FoundryPrinter/Kerrby/BOM/3dprinter_BOM2.ods

 | Lobo 3D Printer Part List
 | Lasercut Acrylic Parts |  |  | Cost/Per | Cost/Kit | Shipping
 | Material: 6mm(1/4”) Cast Acrylic sheet 24” x 14.5” |  | http://www.delviesplastics.com/ |  | 19.00 | 4.33 |  | buy in 24x48 sheets (3 units per sheet) – transluscent 1/4”
 | Laser Cutter Source: FULL_LAYOUT.PDF (generated with 0.010” laser kerf compensation)
Qnty | Pieces: | File Name / Part Number:
2 | Side | Support_Bracket.SPDPRT
1 | Back Plate | Back_Plate.SLDPRT
1 | Bottom Plate | Bottom_Plate.SLDPRT
1 | Print Table | Print_Table.SLDPRT
2 | Z Carriage Side | Z_Carriage_Side.SLDPRT
3 | Carriage Plate | Carriage_Plate.SLDPRT
12 | Rail Bracket | Rail_Bracket.SLDPRT
2 | Belt Clamp | Belt_Puller.SLDPRT
1 | Back Cover | Electronics_Cover.SLDPRT
1 | Foot | Stablizer_Foot.SLDPRT
 | 3D Printed Parts (PLA)
1 | Rocker Arm | rocker.SLDPRT, ROCKER.STL
1 | Duct | blowerduct.SLDPRT, blowerduct.STL
1 | Tube Clamp | Extruder_Top_Tube_Holder.SLDPRT, Extruder_Top_Tube_Holder.STL
2 | Pulley | MXL18_PRINT.SLDPRT, MXL18_PRINT.STL
1 | SD Adapter Holder | SDHOLDER.SLDPRT, SDHOLDER.STL (optional)
 | Fabricated Metal Parts
6 | Rail | 1/2” x 1/8”Aluminum Angle x 8.5” long,6063-T52, hard anodize (Type III) |  | 0.71 | 4.26 | 4.63 |  | 5' lengths https://www.onlinemetals.com/merchant.cfm?pid=1014&step=4&showunits=inches&id=63&top_cat=60
1 | Extruder Plate | EXTRUDERPLATE.SLDPRT, (0.125” aluminum plate) |  | 5.00 | 5.00
1 | Heater Block | HEATERBLOCK.SLDPRT (aluminum) |  | 8.00 | 8.00
1 | Feeder Tube | TUBE.SLDPRT, McMaster 6100K482 |  | 1.25 | 1.25 |  |  | Alternate ? 8987K24
1 | Tube Clamp | TUBECLAMP.SLDPRT (aluminum) |  | 6.00 | 6.00
1 | Spring Bracket | (1/16” aluminum sheet) |  | 2.00 | 2.00
1 | Build Plate | (1/16” aluminum sheet) |  | 1.00 | 1.00 |  | 27.51
 | Mechanical Components
4 | Motor | Wantai Nema 17, 34mm, .4A |  | 9.86 | 39.44 | 0.00 |  | http://www.ebay.com/itm/Free-shipping-10PCS-CNC-Nema17-12VDC-2800g-cm-34mm-length-4-Lead-1-8-/140906378602
1 | Blower | Digikey.com 259-1316-ND |  | 8.00 | 8.00
15 | Bearing | 608-2RS bearing |  | 0.35 | 5.25 | 0.00 |  | http://www.ebay.com/itm/Qty-100-608-2RS-two-side-rubber-seals-bearing-608-rs-ball-bearings-608-rs-/130963688742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
42 | Belting | MXL 1/4” wide |  | 0.10 | 4.20 | 0.00 |  | 2x24” lengths http://www.ebay.com/itm/261451500198
1 | Nozzle | MK8 compatible |  | 1.50 | 1.50 | 0.00 |  | http://www.ebay.com/itm/5pcs-0-4mm-Copper-Extruder-Nozzle-Print-Head-1-75mm-MK8-3D-Printer-/301583572301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
1 | Drive Gear |  |  | 3.08 | 3.08 | 0.00 |  | http://www.ebay.com/itm/221680385921
1 | Teflon Sleeve 0.022 ID | McMaster 5335K12 |  |  |  |  |  | 4 Inches per unit
1 | Teflon Sleeve 0.076” ID | McMaster 5335K18 |  | 0.08 | 0.08 |  |  | 2” per unit
1 | Nylon Spacer ¼ OD x 5/8 | McMaster 94639A107 |  | 0.09 | 0.09
1 | Spring 1.375" Long,.281" OD | McMaster 9657K108 |  | 0.53 | 0.53 |  |  | Century C-612
2 | 6-32 x 1/4” set screw | McMaster 92313A144 |  | 0.03 | 0.06
4 | 4-40 x 3/16 pan head | McMaster 90272A105 |  | 0.02 | 0.06
1 | 4-40 x 3/8 pan head | McMaster 90272A108 |  | 0.02 | 0.02
1 | 6-32 x 2” pan | McMaster 90272A159 |  | 0.06 | 0.06
3 | 8-32 x 5/8 FH Socket | McMaster 92210A196 |  | 0.06 | 0.18
12 | 8-32 x ½ FH Socket | McMaster 92210A194 |  | 0.06 | 0.72
1 | M3 x 25mm | McMaster 92005A130 |  | 0.03 | 0.03
9 | M3 x 10mm | McMaster 92005A120 |  | 0.03 | 0.27
3 | 6-32 x ½ Pan Head | McMaster 90272A148 |  | 0.02 | 0.06
34 | 6-32 x 3/8 Pan Head | McMaster 90272A146 |  | 0.02 | 0.68
6 | 6-32 square nut | McMaster 94855A201 |  | 0.02 | 0.12
30 | #8 Plastic Washers | McMaster 90295A410 |  | 0.07 | 2.10
4 | Rubber feet | Hardware Sales |  | 0.15 | 0.60 |  | 67.125
4 | 4-40 M/F standoff x 6mm ( .25 in ) | McMaster 93505A855 |  | 0.36 | 1.44 |  |  | Jameco 393458
2 | 3/16 feeder tube | McMaster 5112K43 |  | 0.44 | 0.88 |  |  | 5548K65
 | m3 x 6mm Pan Head | McMaster 92005A116
 | Electronic Components
1 | Printrboard |  |  | 50.00 | 50.00 | 0.00 |  | http://www.ebay.com/itm/New-Version-Printerboard-Controller-Board-for-Reprap-Prusa-Mendel-3D-Printer-/271504944560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
1 | Heater Cartridge |  |  | 1.67 | 1.67 | 0.00 |  | http://www.ebay.com/itm/201158692987
1 | Thermistor | Digikey 615-1028-ND |  | 1.10 | 1.10
5 | 4-Pin Locking Housing | Digikey WM2002-ND |  | 0.25 | 1.25
1 | 2-Pin Locking Housing | Digikey WM2000-ND |  | 0.20 | 0.20
22 | Sockets for locking conn. | Digikey WM1114-ND |  | 0.07 | 1.54
1 | Connector strip | Jameco.com 103158 |  | 0.60 | 0.60 |  |  | 36 position strip
15 | Sockets for housing | Jameco.com 100766 |  | 0.07 | 1.05
15 | Pins for housing | Jameco.com 145358 |  | 0.07 | 1.05
1 | Power Supply | Newegg.com 9SIA70F2KM9750 |  | 9.35 | 9.35
1 | USB Cable | Newegg.com 9SIA7X42VY8433 |  | 2.00 | 2.00
1 | Power Switch | Digikey CW198-ND |  | 2.00 | 2.00
1 | Power Jack | Digikey CP-6-ND |  | 1.50 | 1.50
1 | Molex power conn. | Digikey WM3701-ND |  | 0.50 | 0.50
2 | Molex pins | Digikey WM2501-ND |  | 0.12 | 0.24
1 | Limit Switch | Digikey SW777-ND |  | 1.10 | 1.10
0 | SD Card Adapter (optional) |  |  | 5.60 | 0.00 |  |  | http://www.dx.com/p/sd-to-microsd-transflash-card-converter-module-27001#.VXXifM9VhBc
 | Supplies
2 | Cable | 24ga, 5 pair |  | 0.41 | 0.82 |  |  | http://www.iec-usa.com/cgi-bin/iec/CAB010-MP-L5-GY
 | Teflon Tape
48 inches | Hookup wire, 26ga | Jameco 173148, 105912
 | Superglue
 | Fishing Line | Vector Fiber 30lb |  |  | Parts | Shipping
 |  |  |  |  | 191.93 | 8.96
 |  |  |  | TOTAL COST | 200.89
