FoundryPrinter/Kerrby/Solidworks/printer.SLDASM

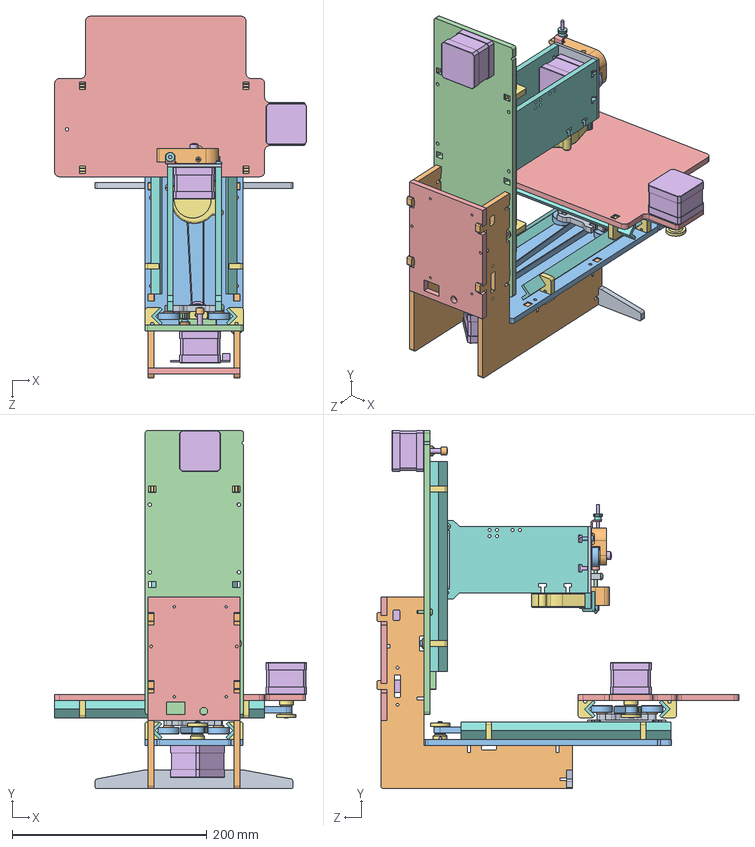
[picture p1: CAD file, 2015-07-31]
Solidworks/printer.SLDASM
259.5 x 368.0 x 371.7 mm
foot
L_bracket x 2
base2
back2
cover
printrboard
railbracket2 x 12
rail x 6
carriageplate3 x 3
washer x 19
bearing x 15
puller x 3
table2
motor x 4
MXL18_print x 2
side2 x 2
tubeclamp
heaterblock
nozzle
tube
tubetop
filamentgear
blower
blowerduct3
extruderplate
rocker
screw_6-32_038 x 3
screw_6-32_050 x 4
springbracket
screw_6-32_250
spring
fingernut
spacer_062
stringclamp
belt x 2
switchplate
