FoundryPrinter/Kerrby/Solidworks/hotend.SLDASM

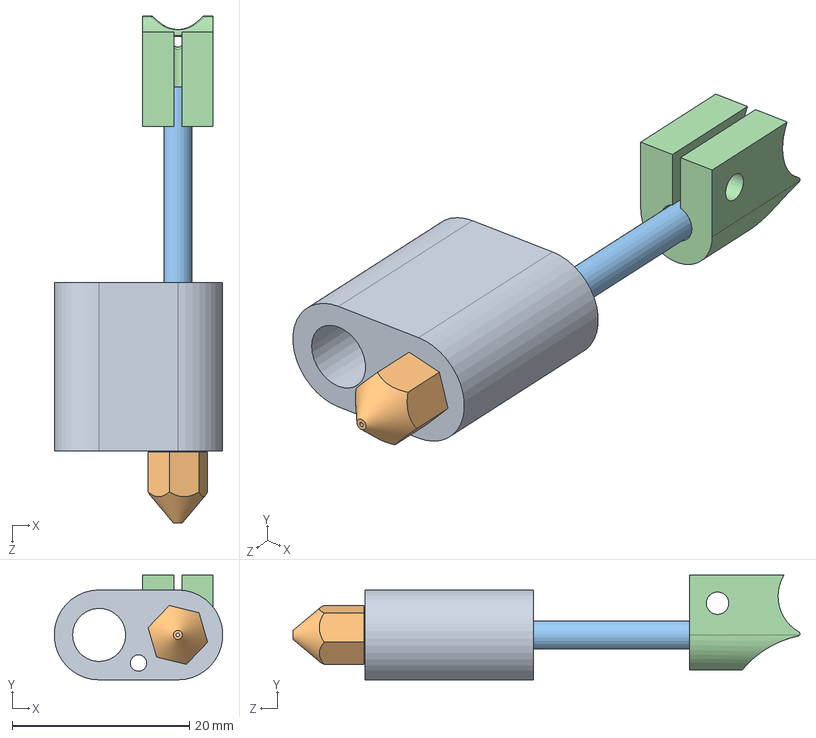
[picture p2: CAD file, 2015-07-31]
Solidworks/hotend.SLDASM
19.0 x 11.8 x 57.3 mm
heaterblock
nozzle
tube
tubetop
