FoundryPrinter/Kerrby/Solidworks/table.SLDASM

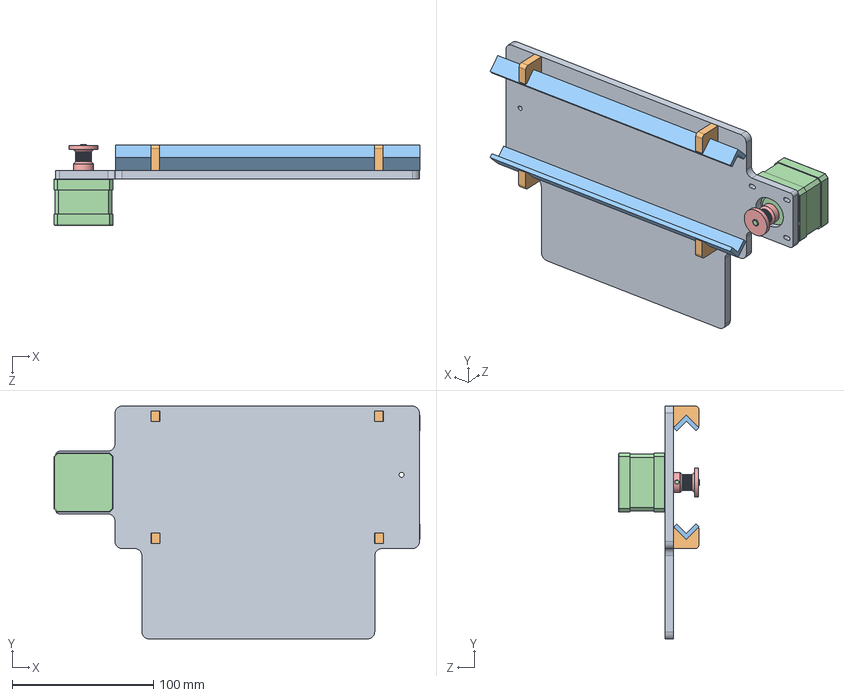
[picture p3: CAD file, 2015-07-31]
Solidworks/table.SLDASM
259.5 x 165.1 x 57.2 mm
table2
railbracket2 x 4
rail x 2
motor
MXL18_print
