FoundryPrinter/Kerrby/Solidworks/carriage.SLDASM

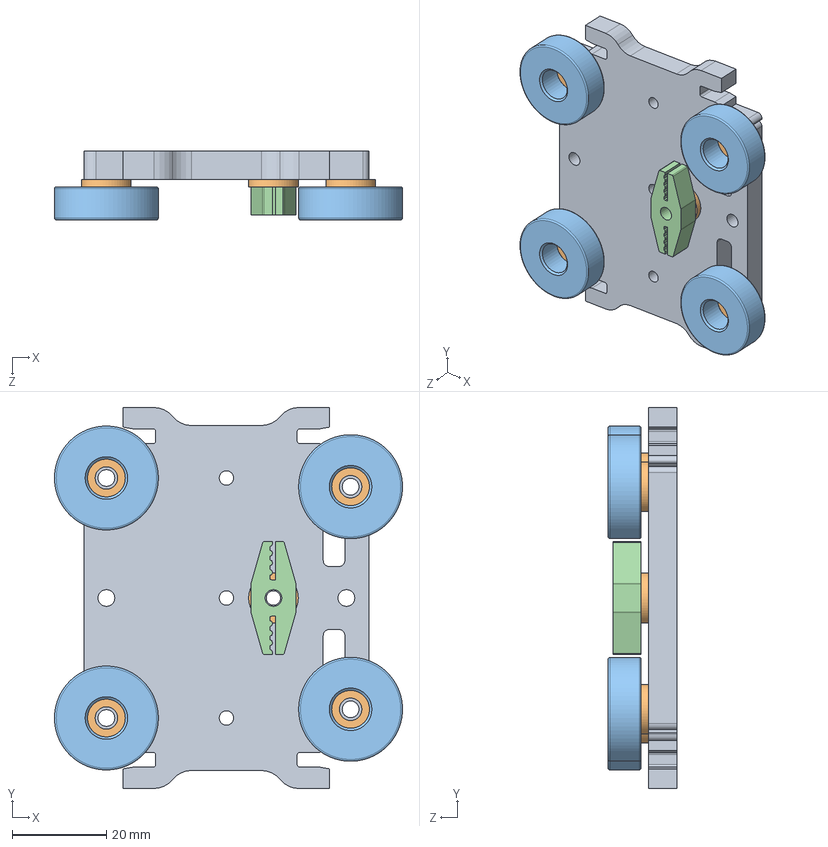
[picture p4: CAD file, 2015-07-24]
Solidworks/carriage.SLDASM
73.7 x 80.6 x 14.6 mm
carriageplate3
washer x 5
bearing x 4
puller
