FoundryPrinter/Kerrby/Solidworks/Backup For SLD 2011/spring.SLDASM

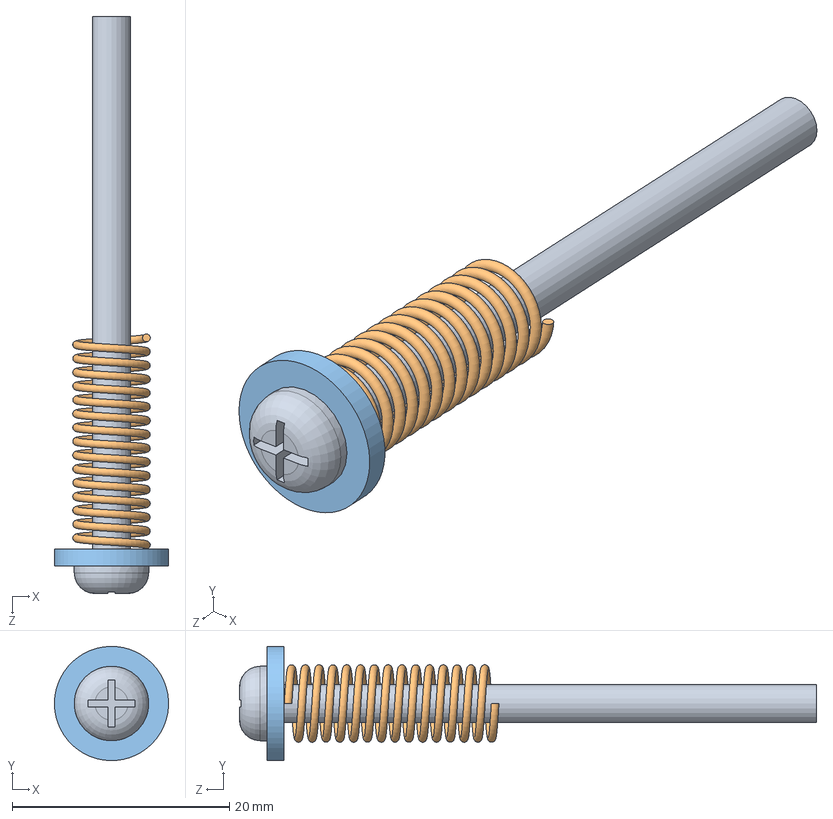
[picture p5: CAD file, 2015-07-17]
Solidworks/Backup For SLD 2011/spring.SLDASM
10.5 x 10.5 x 53.1 mm
screw_6-32_250
spring
washer
