FoundryPrinter/Kerrby/Printed Parts/Blowerduct/blowerduct3_nosupport.STL

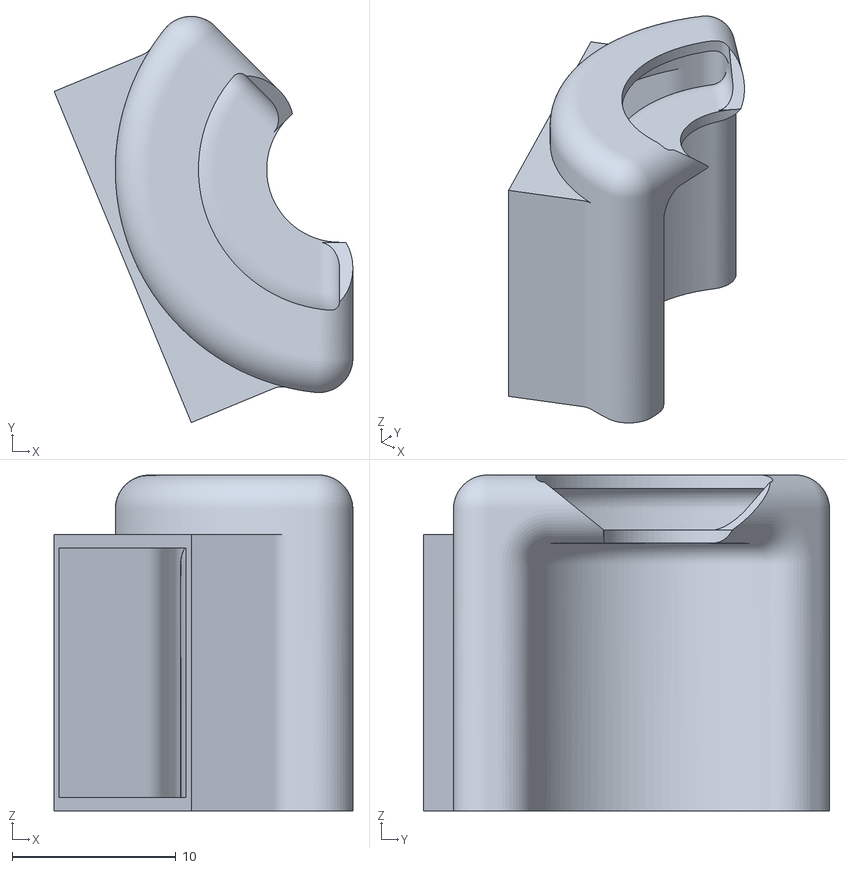
[picture p6: CAD file, 2015-07-17]
Printed Parts/Blowerduct/blowerduct3_nosupport.STL
18.2 x 24.8 x 20.5
