FoundryPrinter/Kerrby/Printed Parts/Drive_Pully/Drive_Pully_MXL18.STL

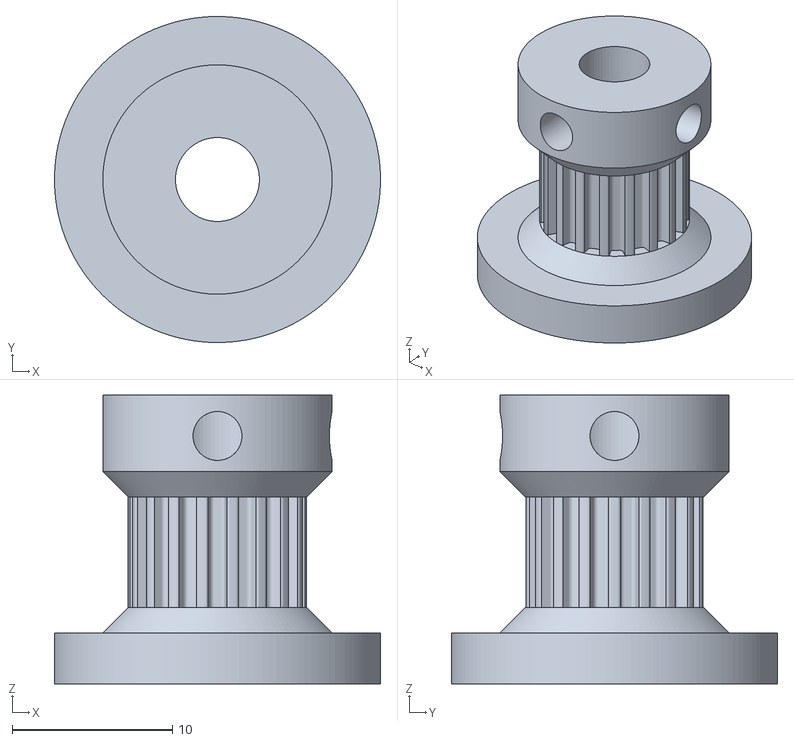
[picture p7: CAD file, 2015-07-17]
Printed Parts/Drive_Pully/Drive_Pully_MXL18.STL
20.3 x 20.3 x 18.0
