FoundryPrinter/Kerrby/Printed Parts/Extruder_Top_Tube_Holder/Extruder_Top_Tube_Holder.STL

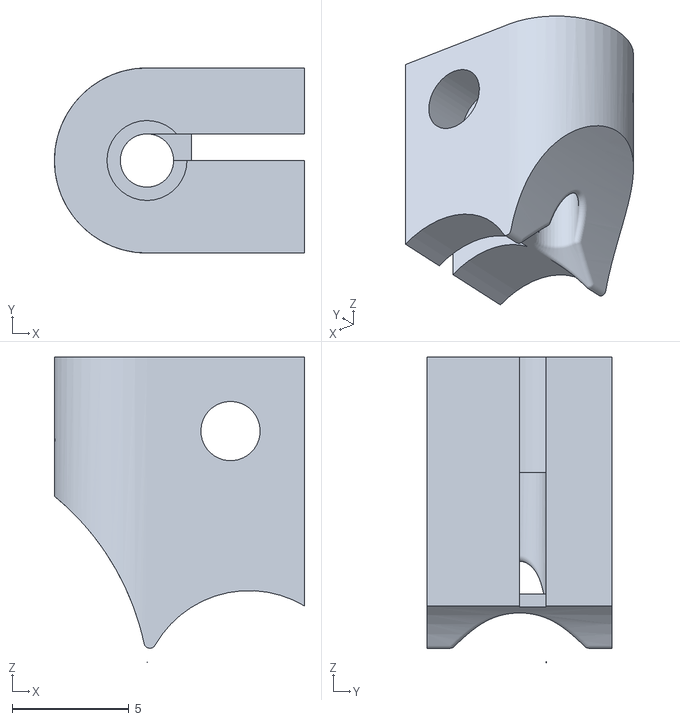
[picture p8: CAD file, 2015-07-31]
Printed Parts/Extruder_Top_Tube_Holder/Extruder_Top_Tube_Holder.STL
10.7 x 7.94 x 13.1
