FoundryPrinter/Kerrby/Printed Parts/Filiment_Rocker/Filiment_Rocker.STL

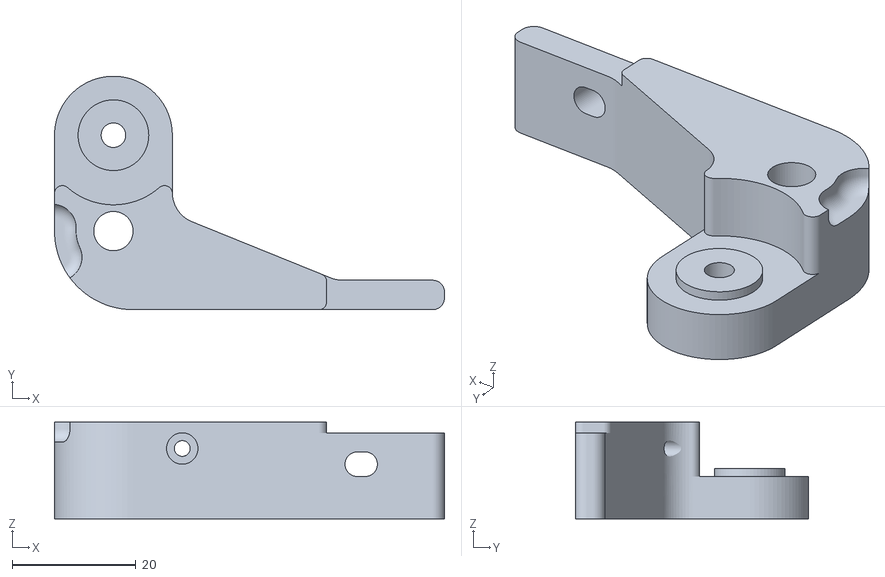
[picture p9: CAD file, 2015-07-17]
Printed Parts/Filiment_Rocker/Filiment_Rocker.STL
63.0 x 37.7 x 15.6
