FoundryPrinter/Kerrby/Printed Parts/SD_Card_Holder/SD_Card_Holder.STL

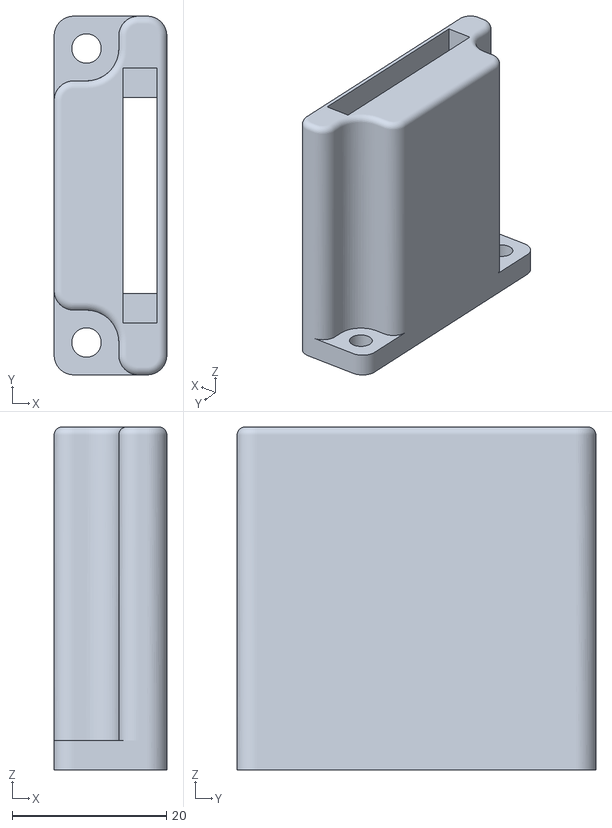
[picture p10: CAD file, 2015-07-17]
Printed Parts/SD_Card_Holder/SD_Card_Holder.STL
14.6 x 46.5 x 44.5
