FoundryPrinter/Kerrby/Solidworks/Backup For SLD 2011/bearing.SLDPRT

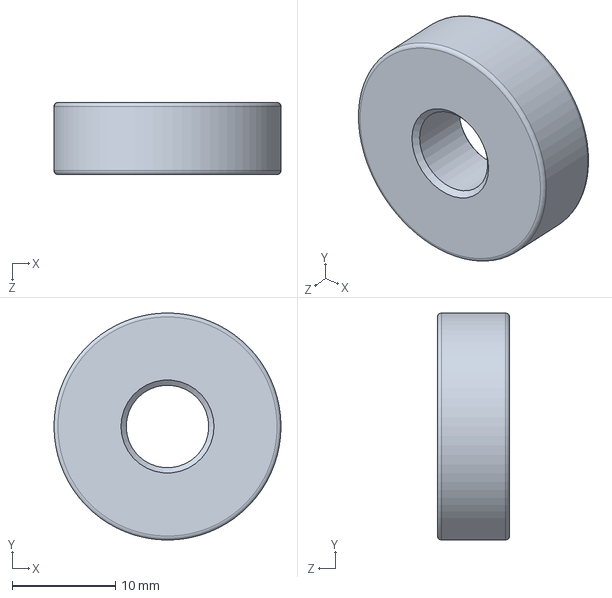
[picture p11: CAD file, 2015-07-17]
Solidworks/Backup For SLD 2011/bearing.SLDPRT
22.0 x 22.0 x 7.00 mm
