FoundryPrinter/Kerrby/Solidworks/Backup For SLD 2011/sdholder_flanged.SLDPRT

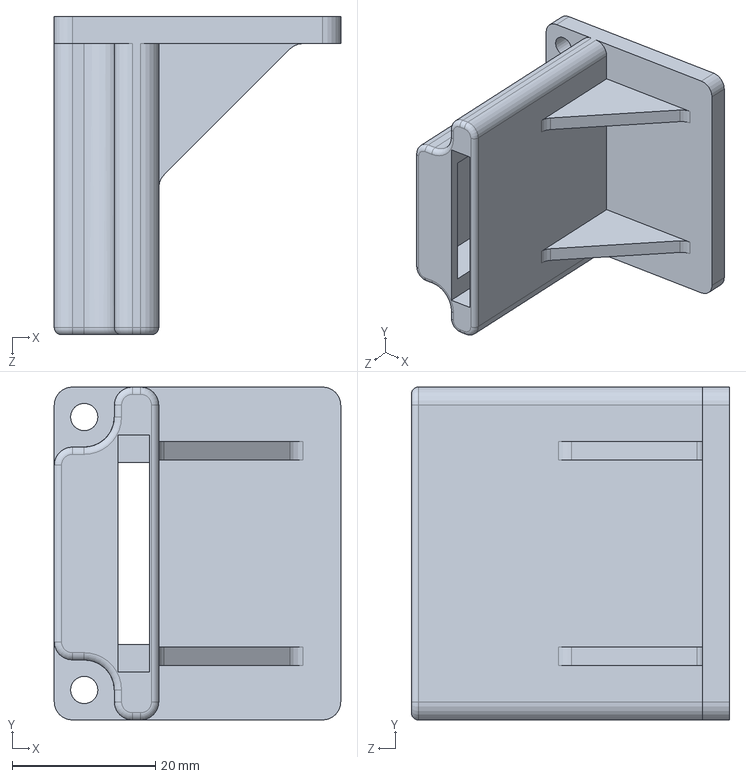
[picture p12: CAD file, 2015-07-17]
Solidworks/Backup For SLD 2011/sdholder_flanged.SLDPRT
40.0 x 46.5 x 44.5 mm
