FoundryPrinter/Kerrby/Solidworks/Backup For SLD 2011/puller.SLDPRT

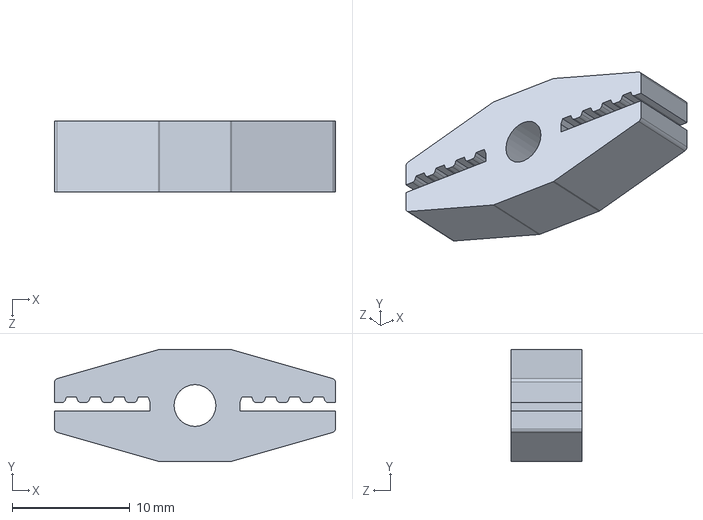
[picture p13: CAD file, 2015-07-17]
Solidworks/Backup For SLD 2011/puller.SLDPRT
23.9 x 9.53 x 6.00 mm
