FoundryPrinter/Kerrby/Solidworks/Backup For SLD 2011/blower.SLDPRT

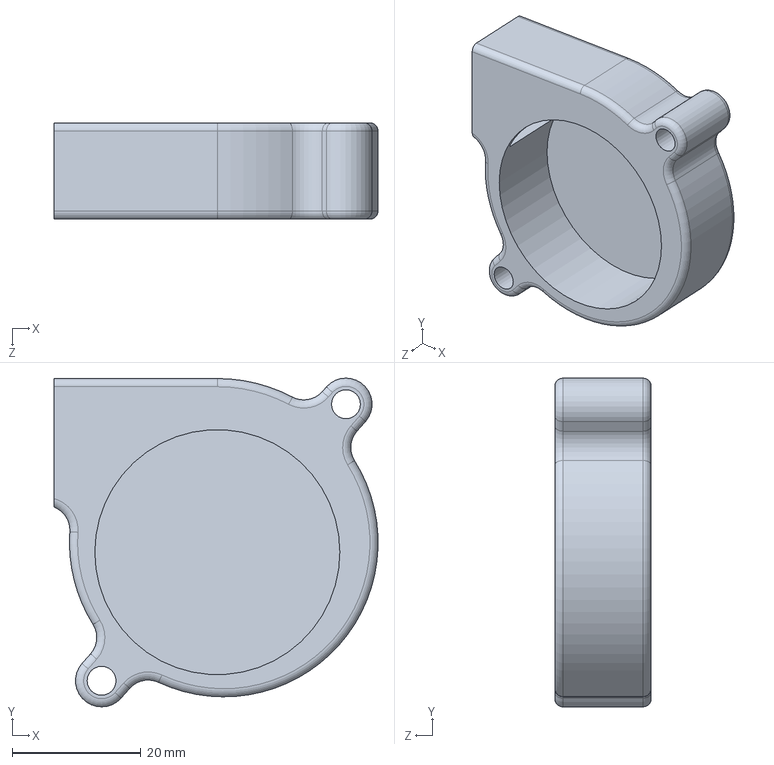
[picture p14: CAD file, 2015-07-17]
Solidworks/Backup For SLD 2011/blower.SLDPRT
50.4 x 51.1 x 15.0 mm
