FoundryPrinter/Kerrby/Solidworks/Backup For SLD 2011/extruderplate.SLDPRT

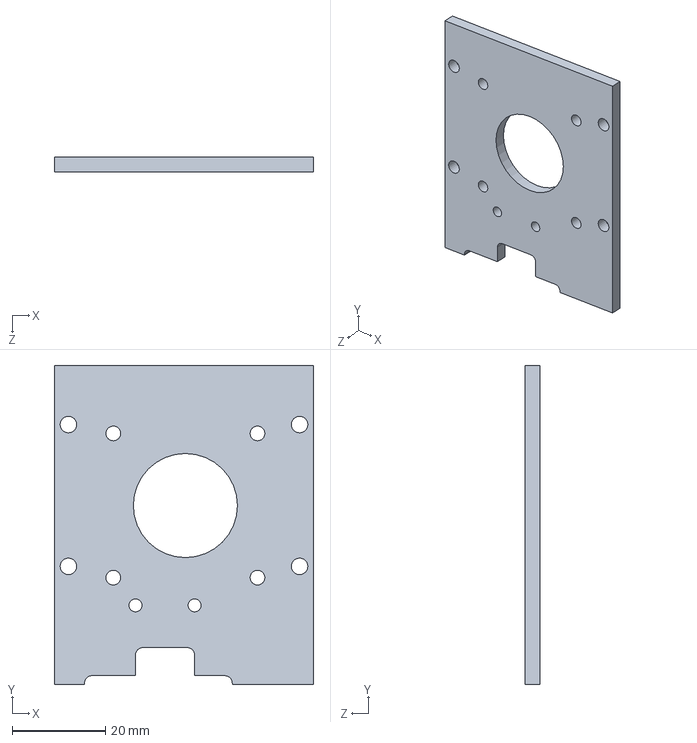
[picture p15: CAD file, 2015-07-17]
Solidworks/Backup For SLD 2011/extruderplate.SLDPRT
55.7 x 68.6 x 3.17 mm
