FoundryPrinter/Kerrby/Solidworks/Bottom_Plate.SLDPRT

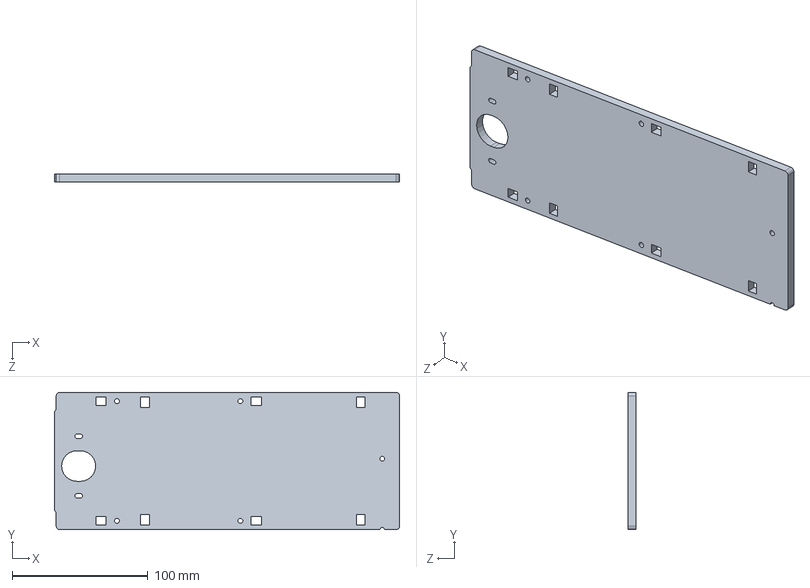
[picture p16: CAD file, 2015-07-17]
Solidworks/Bottom_Plate.SLDPRT
254.0 x 101.0 x 6.00 mm
