FoundryPrinter/Kerrby/Solidworks/Support_Bracket.SLDPRT

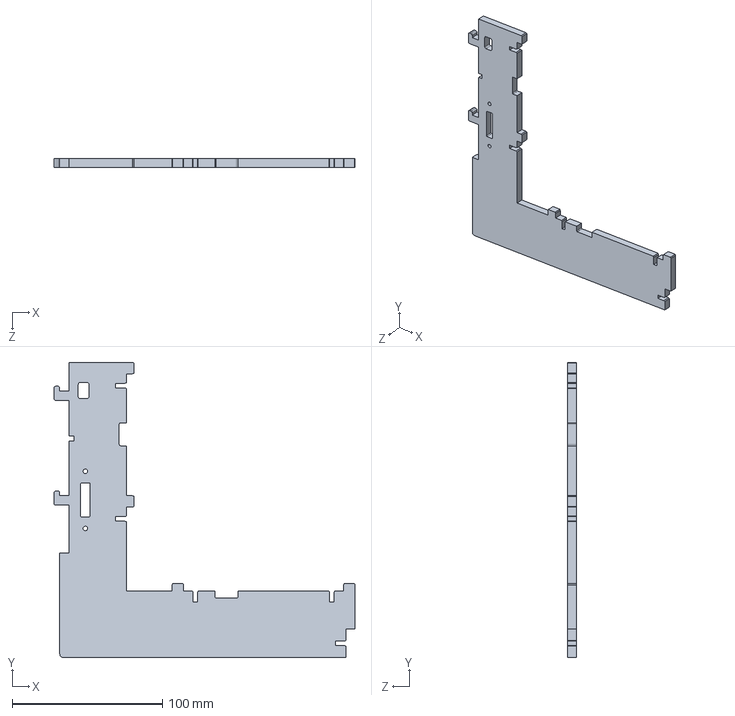
[picture p17: CAD file, 2015-07-17]
Solidworks/Support_Bracket.SLDPRT
200.7 x 196.9 x 6.00 mm
