FoundryPrinter/Kerrby/Solidworks/Backup For SLD 2011/switchplate.SLDPRT

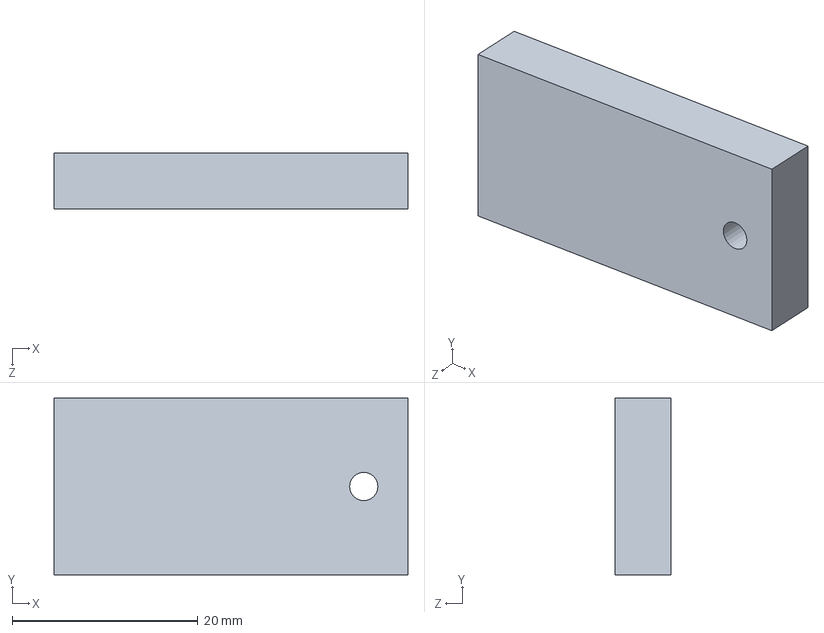
[picture p18: CAD file, 2015-07-17]
Solidworks/Backup For SLD 2011/switchplate.SLDPRT
38.1 x 19.1 x 6.00 mm
