FoundryPrinter/Kerrby/Solidworks/Support_Foot.SLDPRT

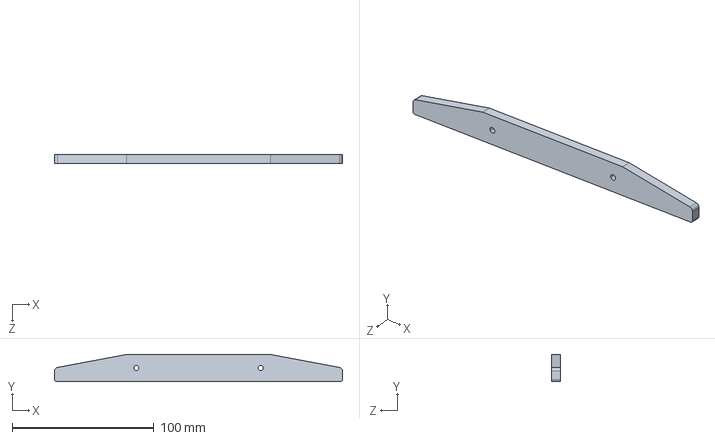
[picture p19: CAD file, 2015-07-17]
Solidworks/Support_Foot.SLDPRT
203.2 x 19.1 x 6.00 mm
