FoundryPrinter/Kerrby/Solidworks/Electronics_Cover.SLDPRT

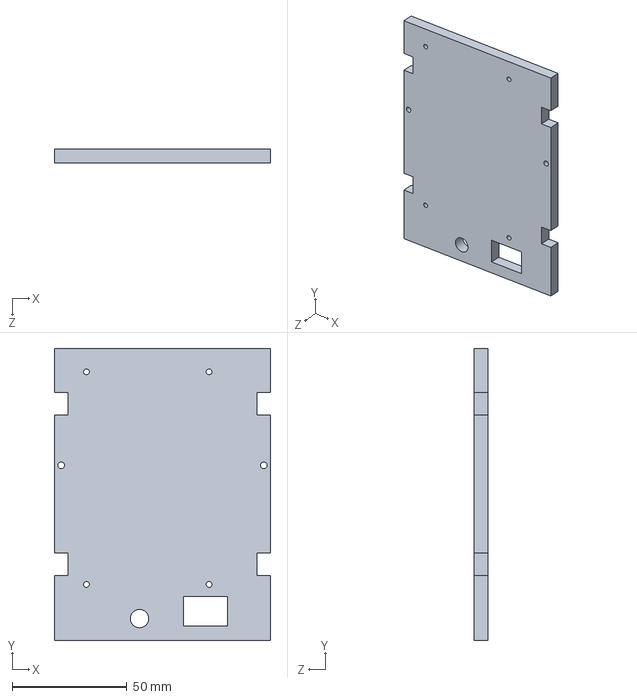
[picture p20: CAD file, 2015-07-17]
Solidworks/Electronics_Cover.SLDPRT
94.1 x 127.0 x 6.00 mm
