FoundryPrinter/Kerrby/Solidworks/Back_Plate.SLDPRT

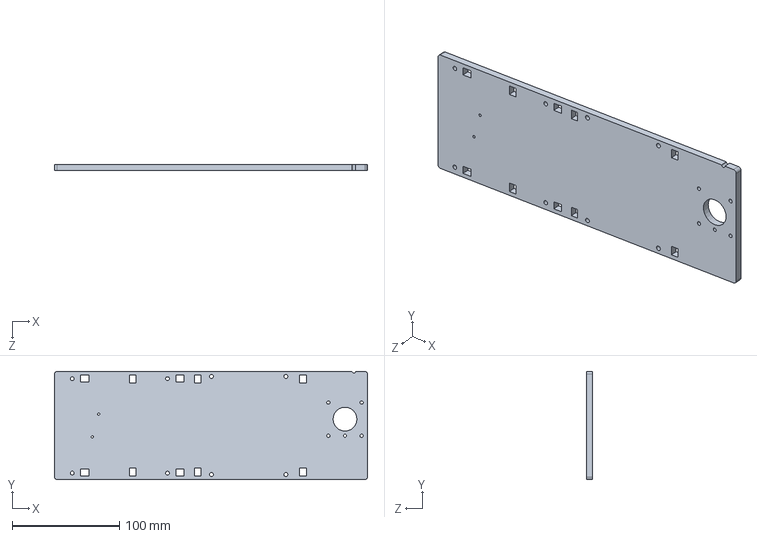
[picture p21: CAD file, 2015-07-17]
Solidworks/Back_Plate.SLDPRT
292.1 x 101.0 x 6.00 mm
