FoundryPrinter/Kerrby/Solidworks/Backup For SLD 2011/spacer_062.SLDPRT

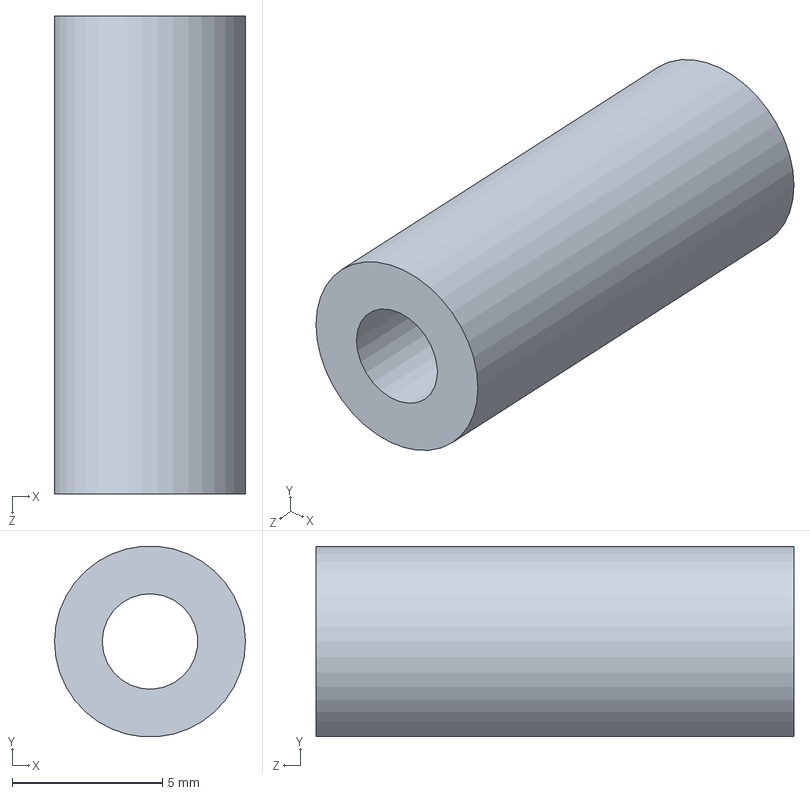
[picture p22: CAD file, 2015-07-17]
Solidworks/Backup For SLD 2011/spacer_062.SLDPRT
6.35 x 6.33 x 15.9 mm
