FoundryPrinter/Kerrby/Solidworks/Rail_Bracket.SLDPRT

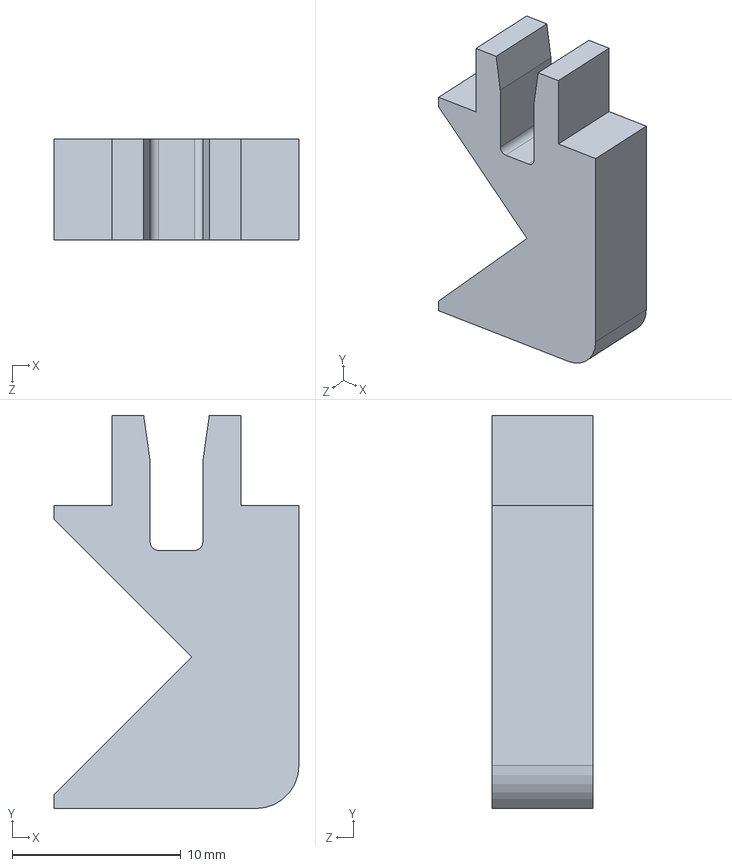
[picture p23: CAD file, 2015-07-17]
Solidworks/Rail_Bracket.SLDPRT
14.5 x 23.3 x 6.00 mm
