FoundryPrinter/Kerrby/Solidworks/Print_Table.SLDPRT

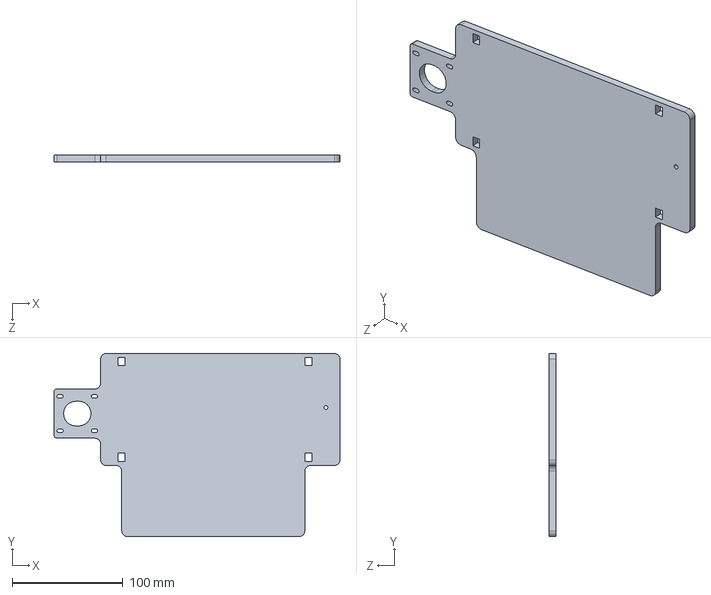
[picture p24: CAD file, 2015-07-17]
Solidworks/Print_Table.SLDPRT
257.9 x 165.1 x 6.00 mm
