FoundryPrinter/Kerrby/Solidworks/Carriage_Plate.SLDPRT

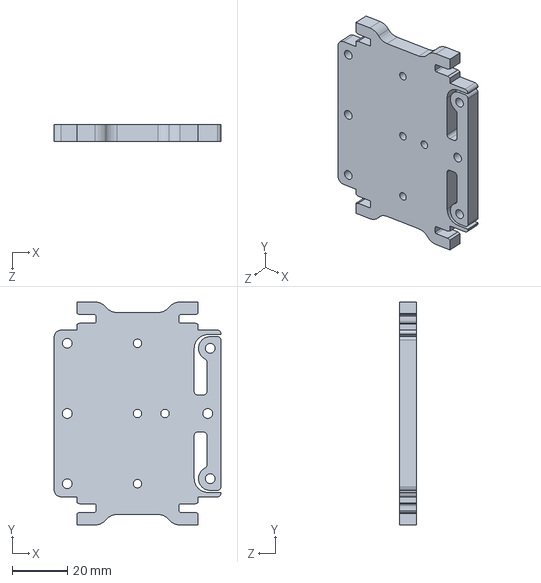
[picture p25: CAD file, 2015-07-17]
Solidworks/Carriage_Plate.SLDPRT
60.3 x 80.6 x 6.00 mm
