FoundryPrinter/Kerrby/Solidworks/Backup For SLD 2011/belt.SLDPRT

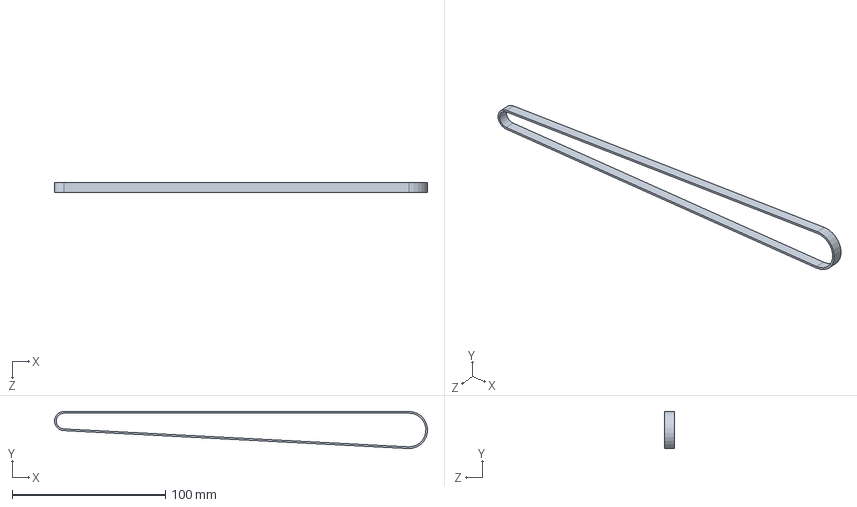
[picture p26: CAD file, 2015-07-17]
Solidworks/Backup For SLD 2011/belt.SLDPRT
243.5 x 24.2 x 6.35 mm
