FoundryPrinter/Kerrby/Solidworks/Z_Carriage_Side.SLDPRT

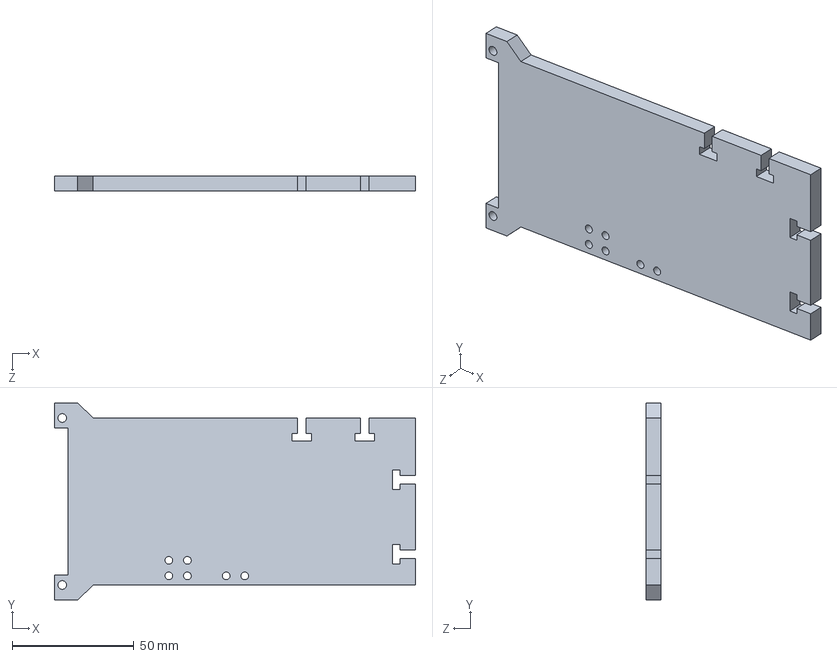
[picture p27: CAD file, 2015-07-17]
Solidworks/Z_Carriage_Side.SLDPRT
148.0 x 80.6 x 6.00 mm
