FoundryPrinter/Kerrby/Solidworks/Backup For SLD 2011/printrboard.SLDPRT

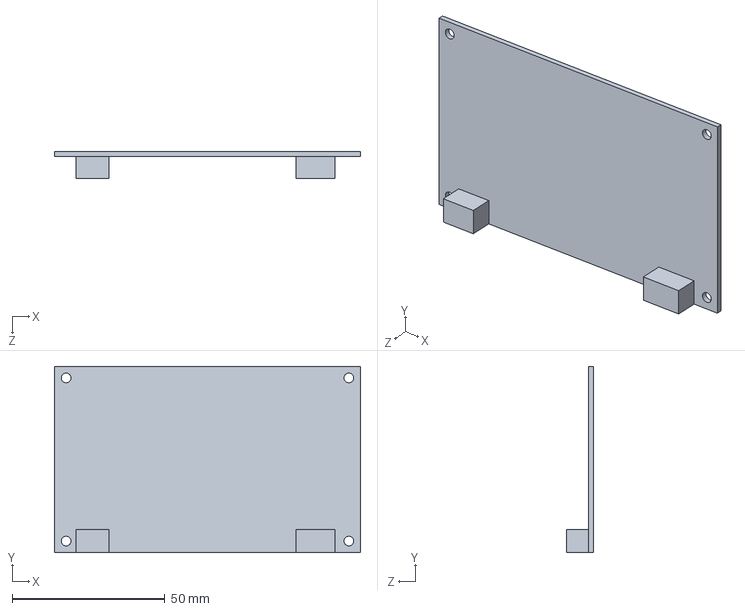
[picture p28: CAD file, 2015-07-17]
Solidworks/Backup For SLD 2011/printrboard.SLDPRT
100.1 x 61.0 x 8.69 mm
