FoundryPrinter/Kerrby/Solidworks/Backup For SLD 2011/fingernut.SLDPRT

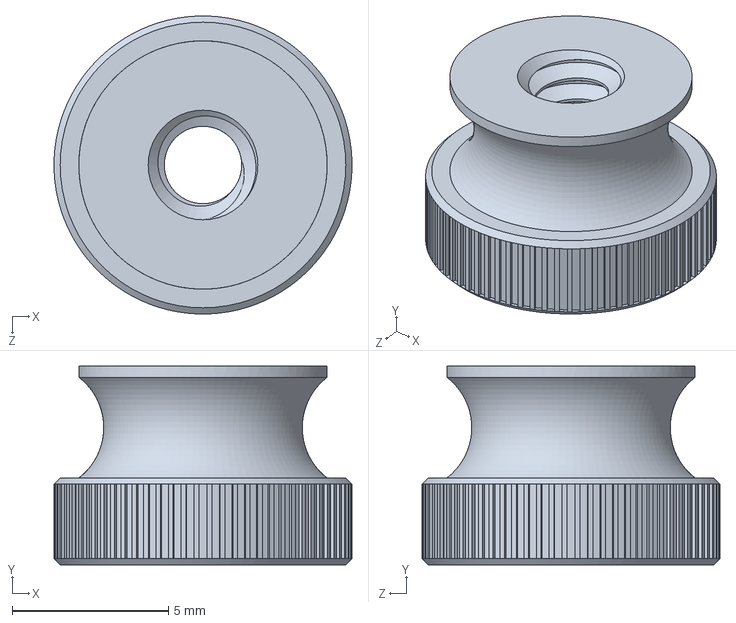
[picture p29: CAD file, 2015-07-17]
Solidworks/Backup For SLD 2011/fingernut.SLDPRT
9.53 x 6.35 x 9.53 mm
