FoundryPrinter/Kerrby/Solidworks/Backup For SLD 2011/tensionbracket.SLDPRT

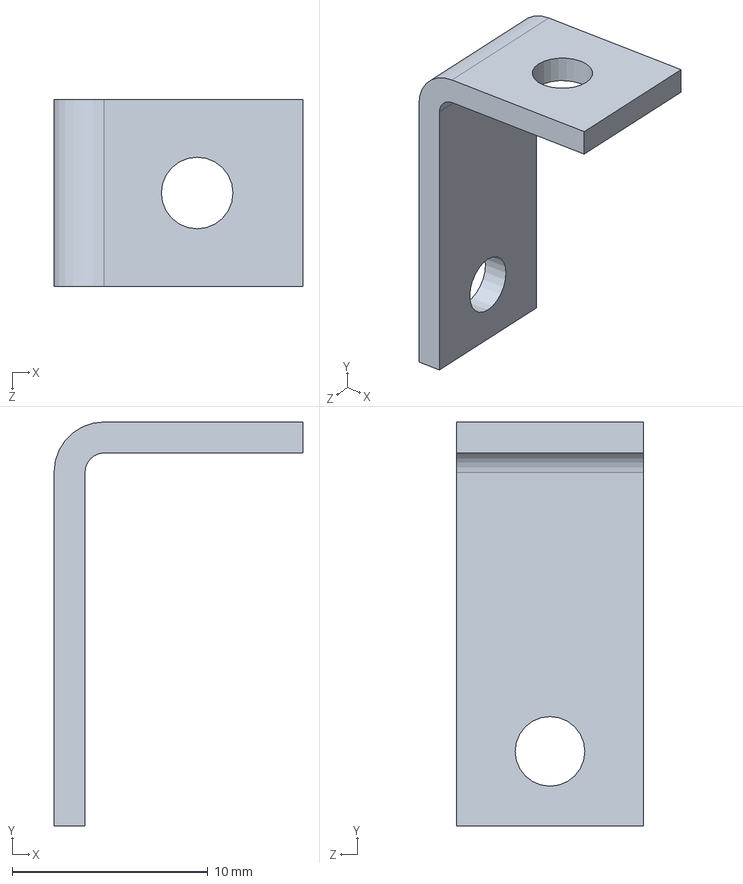
[picture p30: CAD file, 2015-07-17]
Solidworks/Backup For SLD 2011/tensionbracket.SLDPRT
12.7 x 20.6 x 9.53 mm
