FoundryPrinter/Kerrby/Solidworks/Backup For SLD 2011/heaterblock.SLDPRT

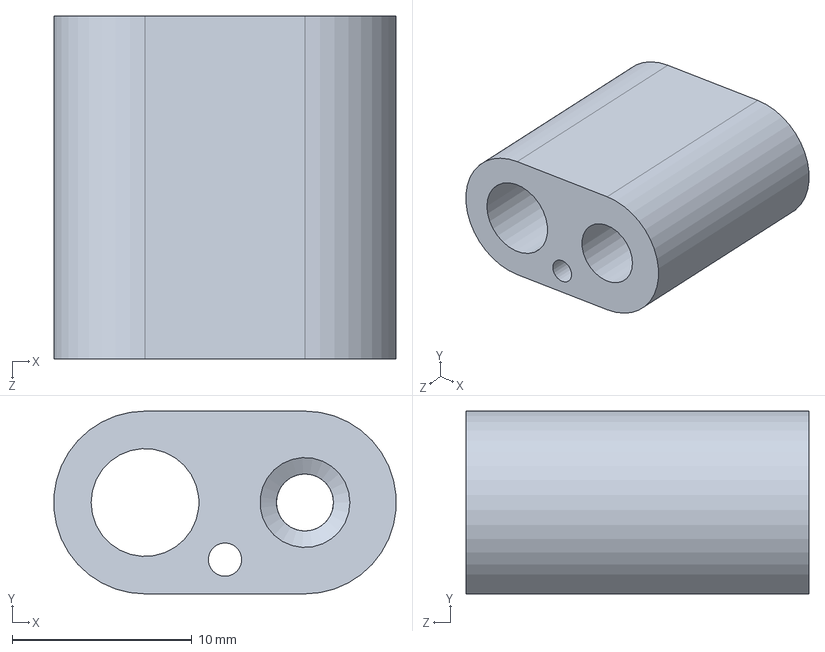
[picture p31: CAD file, 2015-07-17]
Solidworks/Backup For SLD 2011/heaterblock.SLDPRT
19.0 x 10.2 x 19.1 mm
