FoundryPrinter/Kerrby/Solidworks/Backup For SLD 2011/motor.SLDPRT

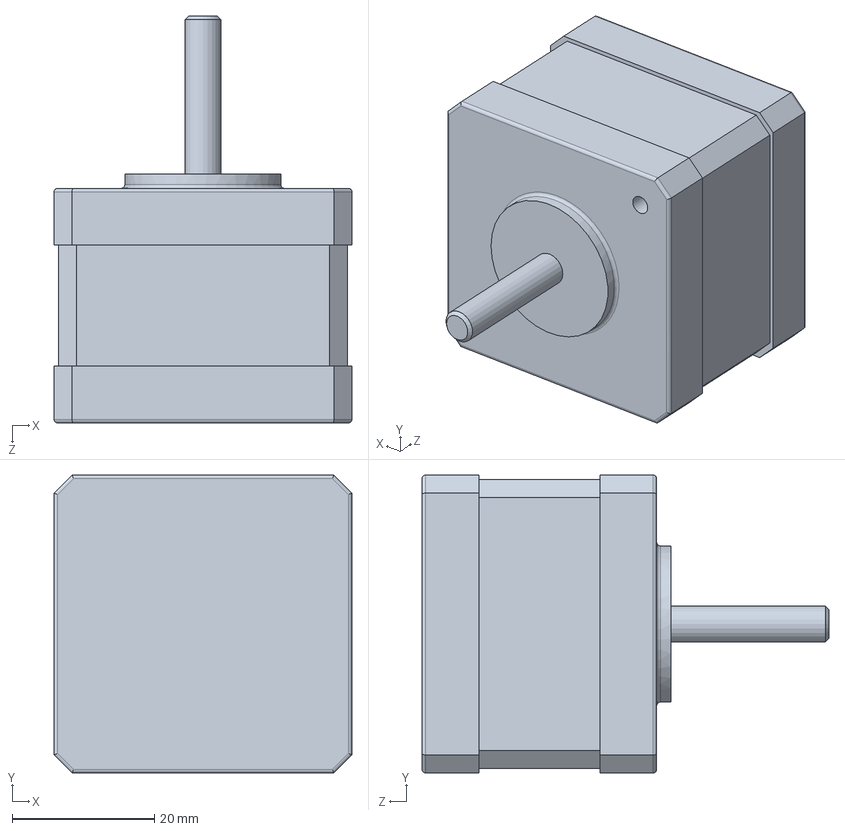
[picture p32: CAD file, 2015-07-17]
Solidworks/Backup For SLD 2011/motor.SLDPRT
41.9 x 41.9 x 57.2 mm
