FoundryPrinter/Kerrby/Solidworks/Backup For SLD 2011/springbracket.SLDPRT

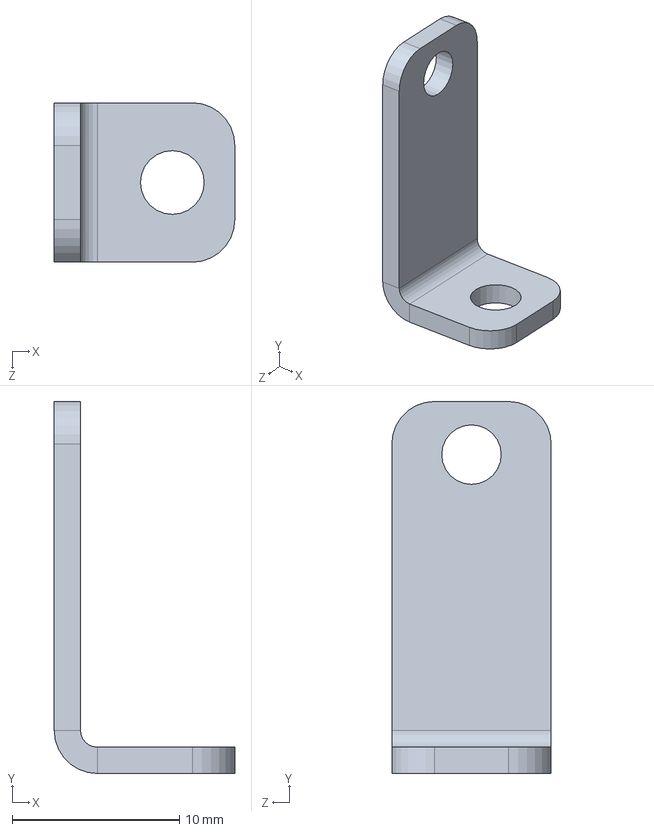
[picture p33: CAD file, 2015-07-17]
Solidworks/Backup For SLD 2011/springbracket.SLDPRT
10.8 x 22.2 x 9.53 mm
