FoundryPrinter/Kerrby/Solidworks/Backup For SLD 2011/stringclamp.SLDPRT

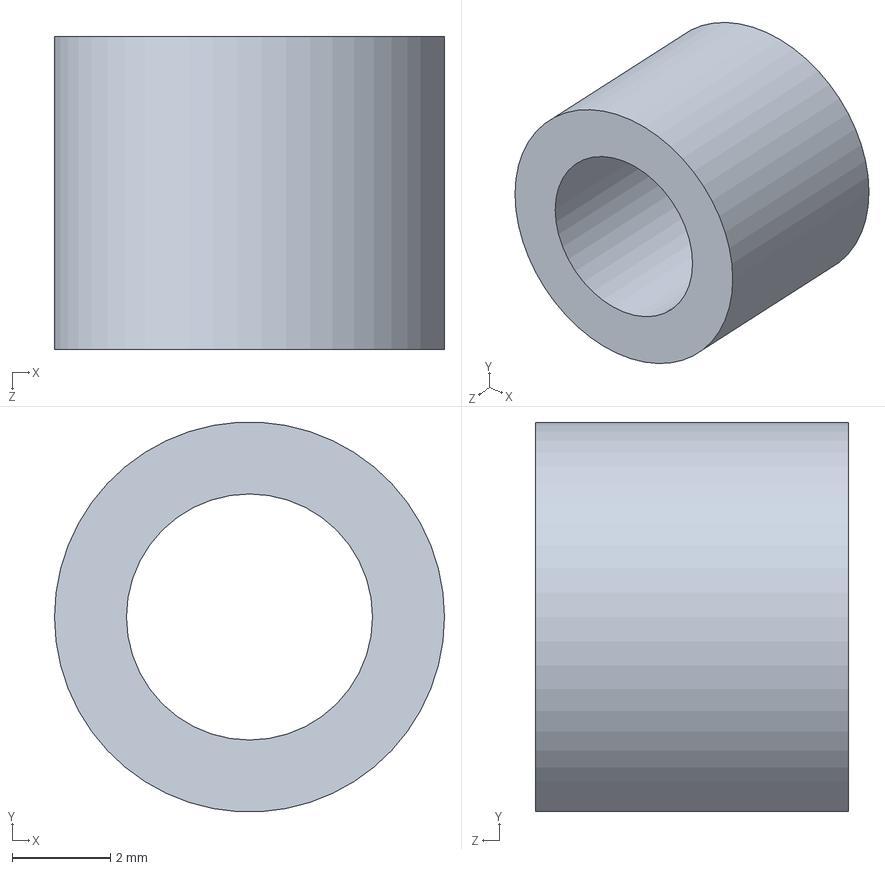
[picture p34: CAD file, 2015-07-17]
Solidworks/Backup For SLD 2011/stringclamp.SLDPRT
7.92 x 7.91 x 6.35 mm
