FoundryPrinter/Kerrby/Solidworks/Backup For SLD 2011/tube.SLDPRT

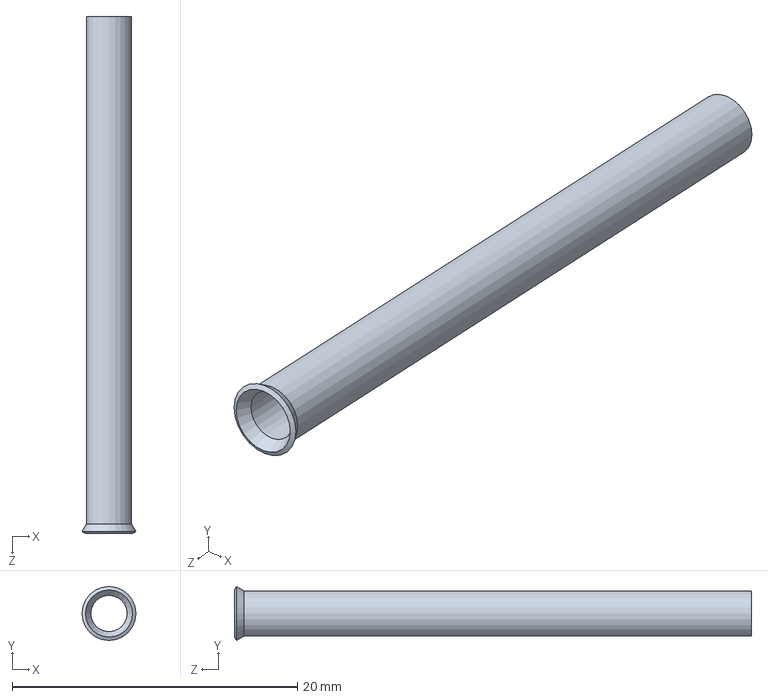
[picture p35: CAD file, 2015-07-17]
Solidworks/Backup For SLD 2011/tube.SLDPRT
3.78 x 3.78 x 36.2 mm
