FoundryPrinter/Kerrby/Solidworks/Backup For SLD 2011/tubeclamp.SLDPRT

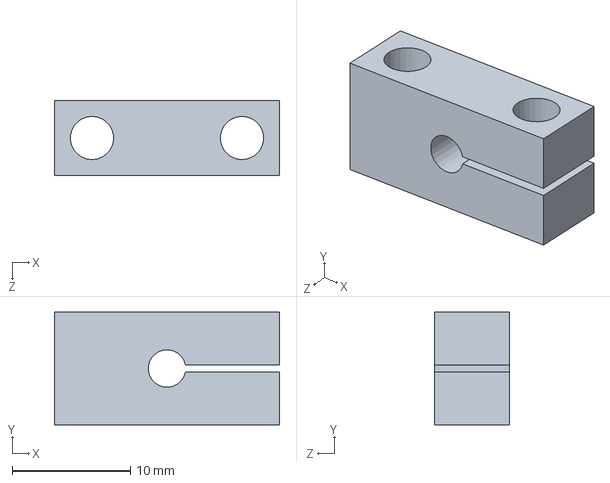
[picture p36: CAD file, 2015-07-17]
Solidworks/Backup For SLD 2011/tubeclamp.SLDPRT
19.1 x 9.53 x 6.35 mm
