FoundryPrinter/Kerrby/Solidworks/Backup For SLD 2011/filamentgear.SLDPRT

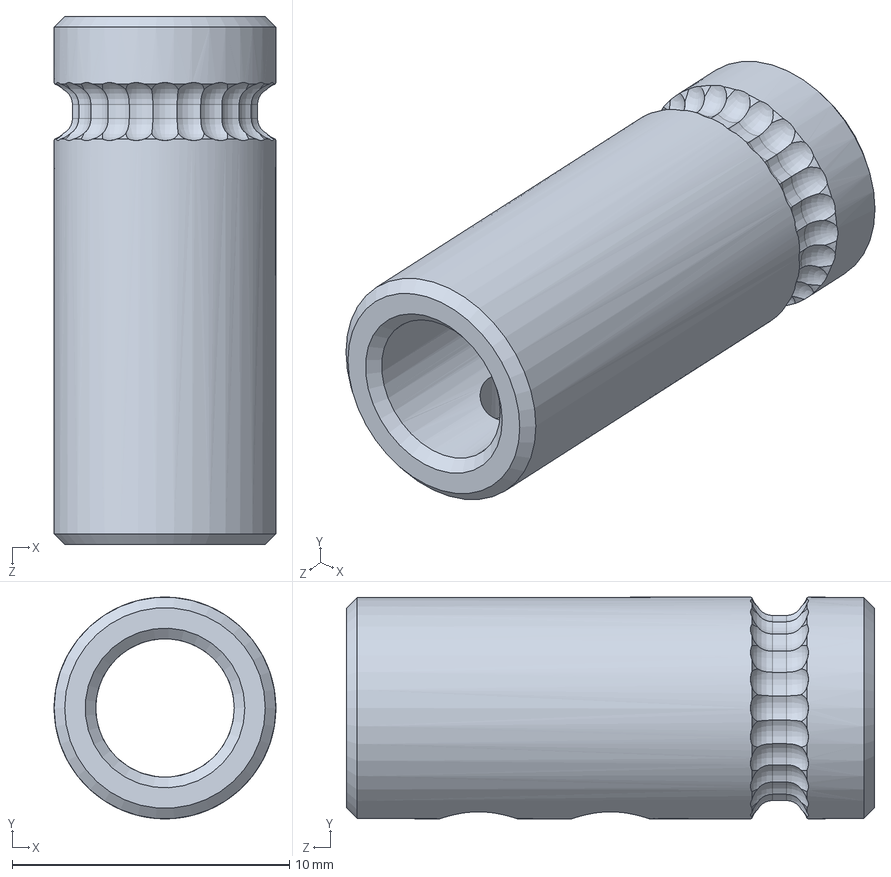
[picture p37: CAD file, 2015-07-17]
Solidworks/Backup For SLD 2011/filamentgear.SLDPRT
8.00 x 8.00 x 19.1 mm
