FoundryPrinter/Kerrby/Solidworks/Backup For SLD 2011/nozzle.SLDPRT

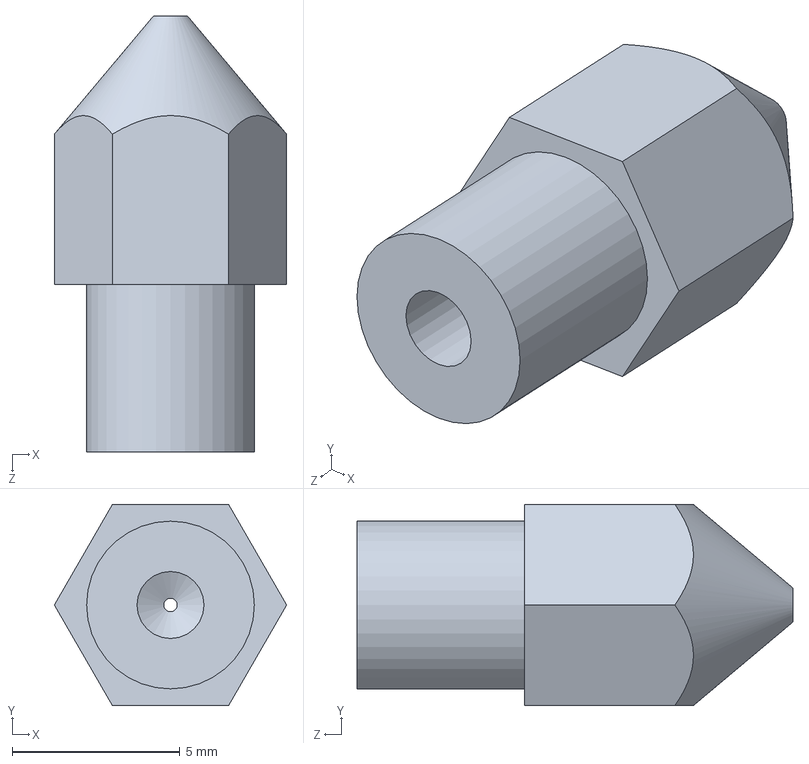
[picture p38: CAD file, 2015-07-17]
Solidworks/Backup For SLD 2011/nozzle.SLDPRT
6.93 x 6.00 x 13.0 mm
