FoundryPrinter/Kerrby/Solidworks/Backup For SLD 2011/rail.SLDPRT

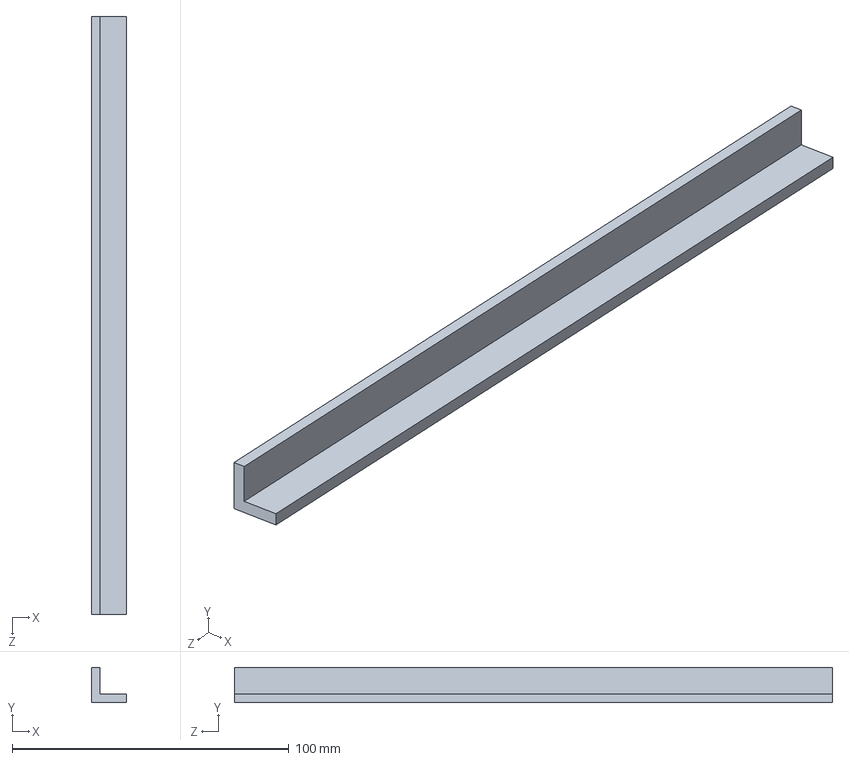
[picture p39: CAD file, 2015-07-17]
Solidworks/Backup For SLD 2011/rail.SLDPRT
12.7 x 12.7 x 215.9 mm
