FoundryPrinter/Kerrby/Solidworks/Backup For SLD 2011/tubetop.SLDPRT

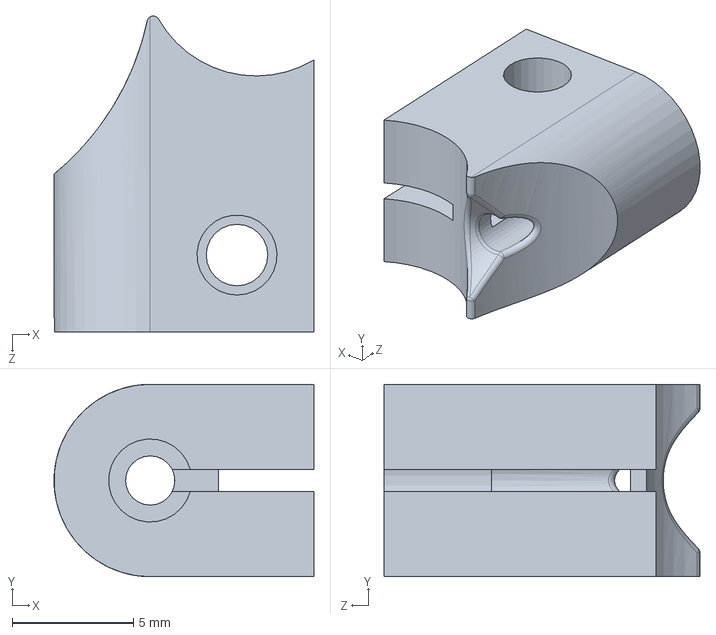
[picture p40: CAD file, 2015-07-17]
Solidworks/Backup For SLD 2011/tubetop.SLDPRT
10.7 x 7.94 x 13.0 mm
