FoundryPrinter/Kerrby/(list of files, cad)

Other CAD files:
Solidworks/Backup For SLD 2011/printer.SLDASM
Solidworks/Backup For SLD 2011/carriage.SLDASM
Solidworks/Backup For SLD 2011/table.SLDASM
Solidworks/Backup For SLD 2011/hotend.SLDASM
Printed Parts/Blowerduct/blowerduct3.STL
Solidworks/Extruder_Top_Tube_Holder.SLDPRT
Solidworks/Blowerduct.SLDPRT
Solidworks/Backup For SLD 2011/rocker.SLDPRT
Solidworks/Backup For SLD 2011/sdholder.SLDPRT
Solidworks/Backup For SLD 2011/MXL18_print.SLDPRT
Solidworks/Backup For SLD 2011/Drawings/L_bracket.SLDDRW
Solidworks/Backup For SLD 2011/Drawings/back2.SLDDRW
Solidworks/Backup For SLD 2011/Drawings/base2.SLDDRW
Solidworks/Backup For SLD 2011/Drawings/carriageplate3.SLDDRW
Solidworks/Backup For SLD 2011/Drawings/cover.SLDDRW
Solidworks/Backup For SLD 2011/Drawings/extruderplate.SLDDRW
Solidworks/Backup For SLD 2011/Drawings/foot.SLDDRW
Solidworks/Backup For SLD 2011/Drawings/heaterblock.SLDDRW
Solidworks/Backup For SLD 2011/Drawings/puller.SLDDRW
Solidworks/Backup For SLD 2011/Drawings/rail.SLDDRW
Solidworks/Backup For SLD 2011/Drawings/railbracket2.SLDDRW
Solidworks/Backup For SLD 2011/Drawings/side2.SLDDRW
Solidworks/Backup For SLD 2011/Drawings/springbracket.SLDDRW
Solidworks/Backup For SLD 2011/Drawings/switchplate.SLDDRW
Solidworks/Backup For SLD 2011/Drawings/table2.SLDDRW
Solidworks/Backup For SLD 2011/Drawings/tubeclamp.SLDDRW
Solidworks/Backup For SLD 2011/screw_6-32_038.SLDPRT
Solidworks/Backup For SLD 2011/screw_6-32_050.SLDPRT
Solidworks/Backup For SLD 2011/screw_6-32_250.SLDPRT
Solidworks/Backup For SLD 2011/spring.SLDPRT
Solidworks/Backup For SLD 2011/washer.SLDPRT
Solidworks/Drawings/L_bracket.SLDDRW
Solidworks/Drawings/back2.SLDDRW
Solidworks/Drawings/base2.SLDDRW
Solidworks/Drawings/carriageplate3.SLDDRW
Solidworks/Drawings/cover.SLDDRW
Solidworks/Drawings/extruderplate.SLDDRW
Solidworks/Drawings/foot.SLDDRW
Solidworks/Drawings/heaterblock.SLDDRW
Solidworks/Drawings/puller.SLDDRW
Solidworks/Drawings/rail.SLDDRW
Solidworks/Drawings/railbracket2.SLDDRW
Solidworks/Drawings/side2.SLDDRW
Solidworks/Drawings/springbracket.SLDDRW
Solidworks/Drawings/switchplate.SLDDRW
Solidworks/Drawings/table2.SLDDRW
Solidworks/Drawings/tubeclamp.SLDDRW
