FoundryPrinter/Kerrby/Printed Parts/Blowerduct/print_spec.txt

##################################################
# Units: mm

Layer Thickness: 0.2

Line Width: 0.4

Infill Percent: 20%

Number Perimeters: 3

Number Solid Bottom Layers: 3

Number Solid Top Layers: 4 

Infill Pattern: Rectilinear

Special Instuctions: 

Use editable supports from Simplify3d, so supports are able to be removed while print remains sucessfull.

( Included is a gcode without supports )
