FoundryPrinter/Kerrby/Printed Parts/Drive_Pully/print_spec.txt

##################################################
# Units: mm

Layer Thickness: 0.2

Line Width: 0.35

Infill Percent: 20%

Number Perimeters: 3

Number Solid Bottom Layers: 3

Number Solid Top Layers: 4 

Infill Pattern: Rectilinear

Special Instuctions:
