FoundryPrinter/Kerrby/Cut files/Full Layout/V3/Full Layout 008line/full_layout3_008line.pdf

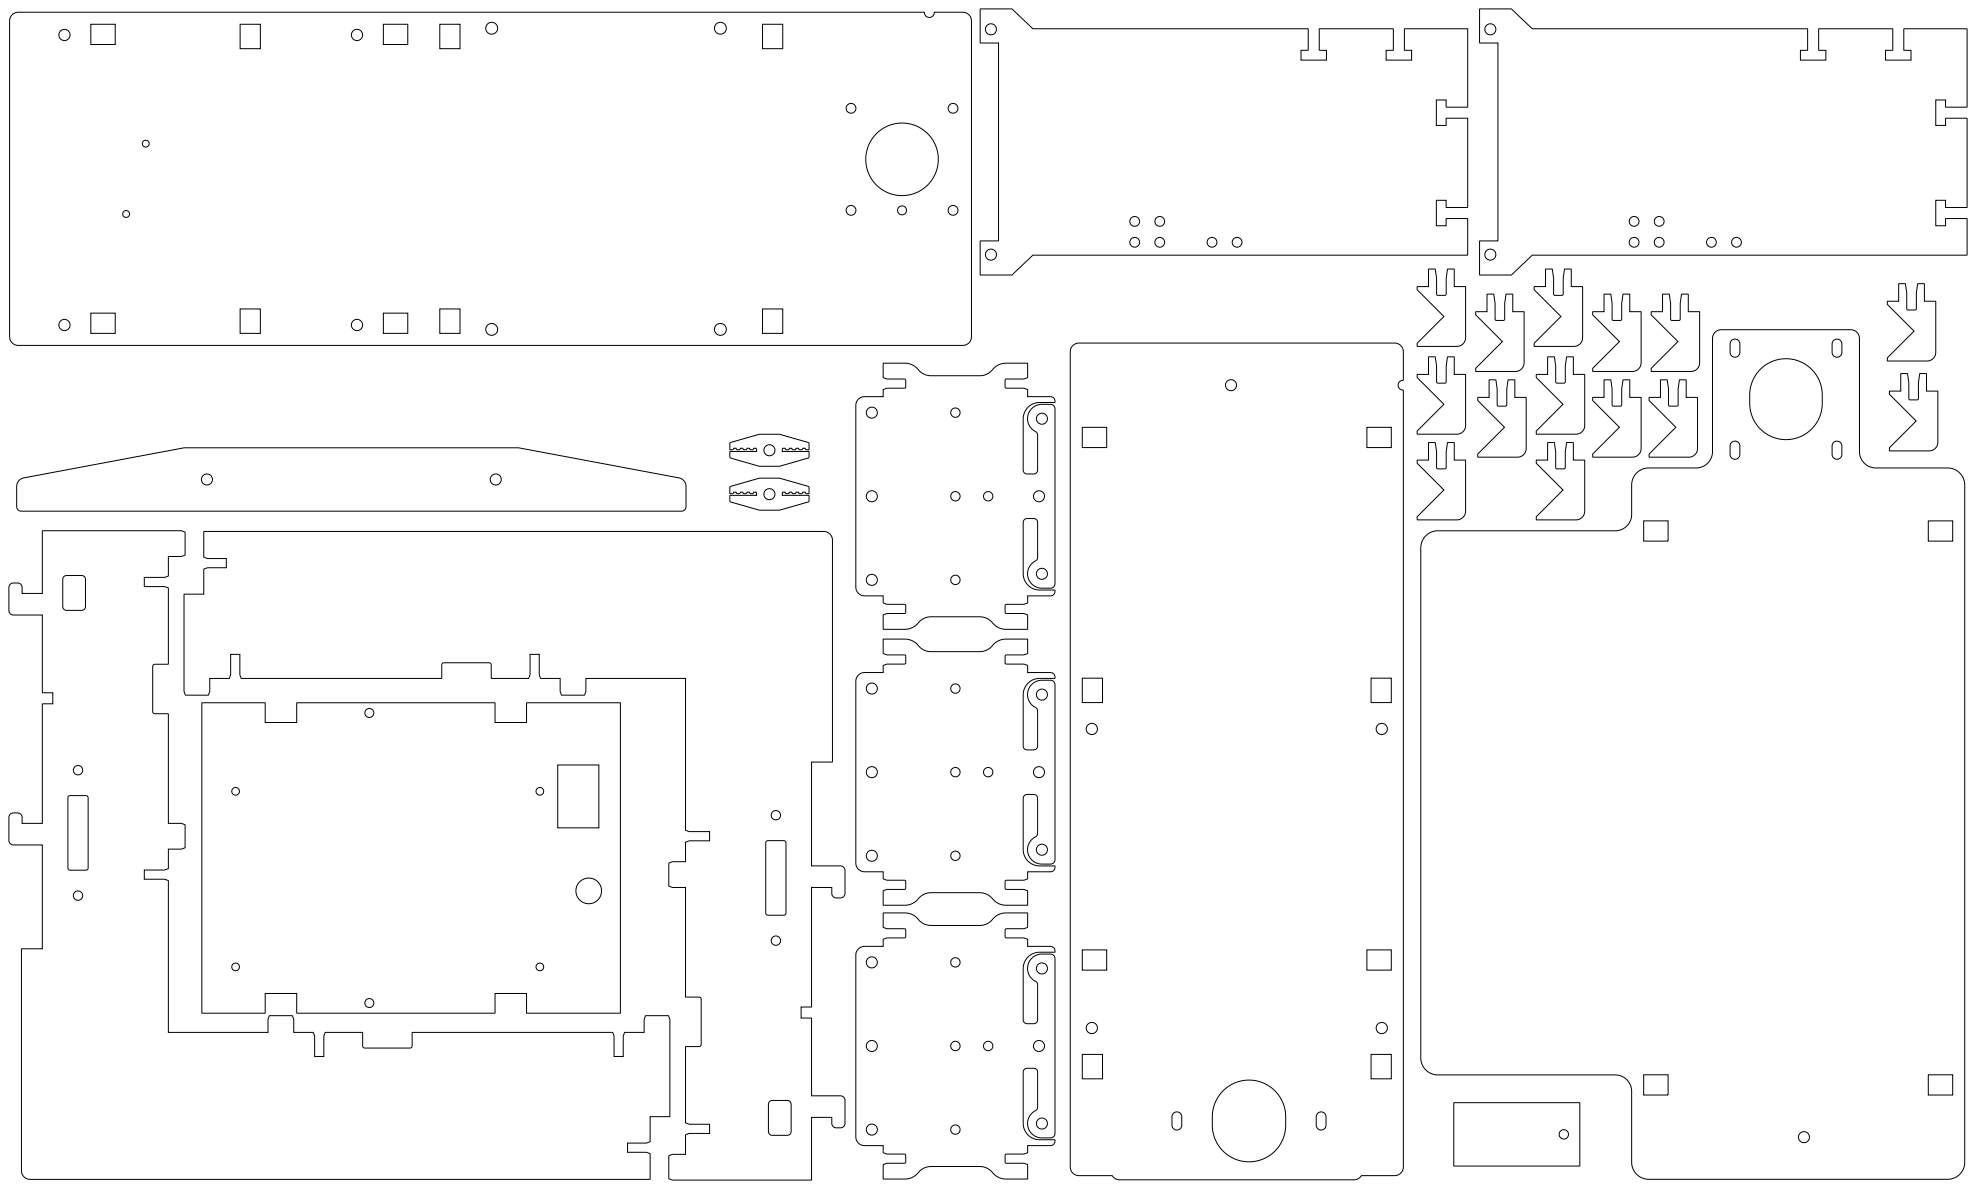
[picture p41: page 1]
