FoundryPrinter/Kerrby/Cut files/Full Layout/V3/Full Layout 010line/full_layout3.pdf

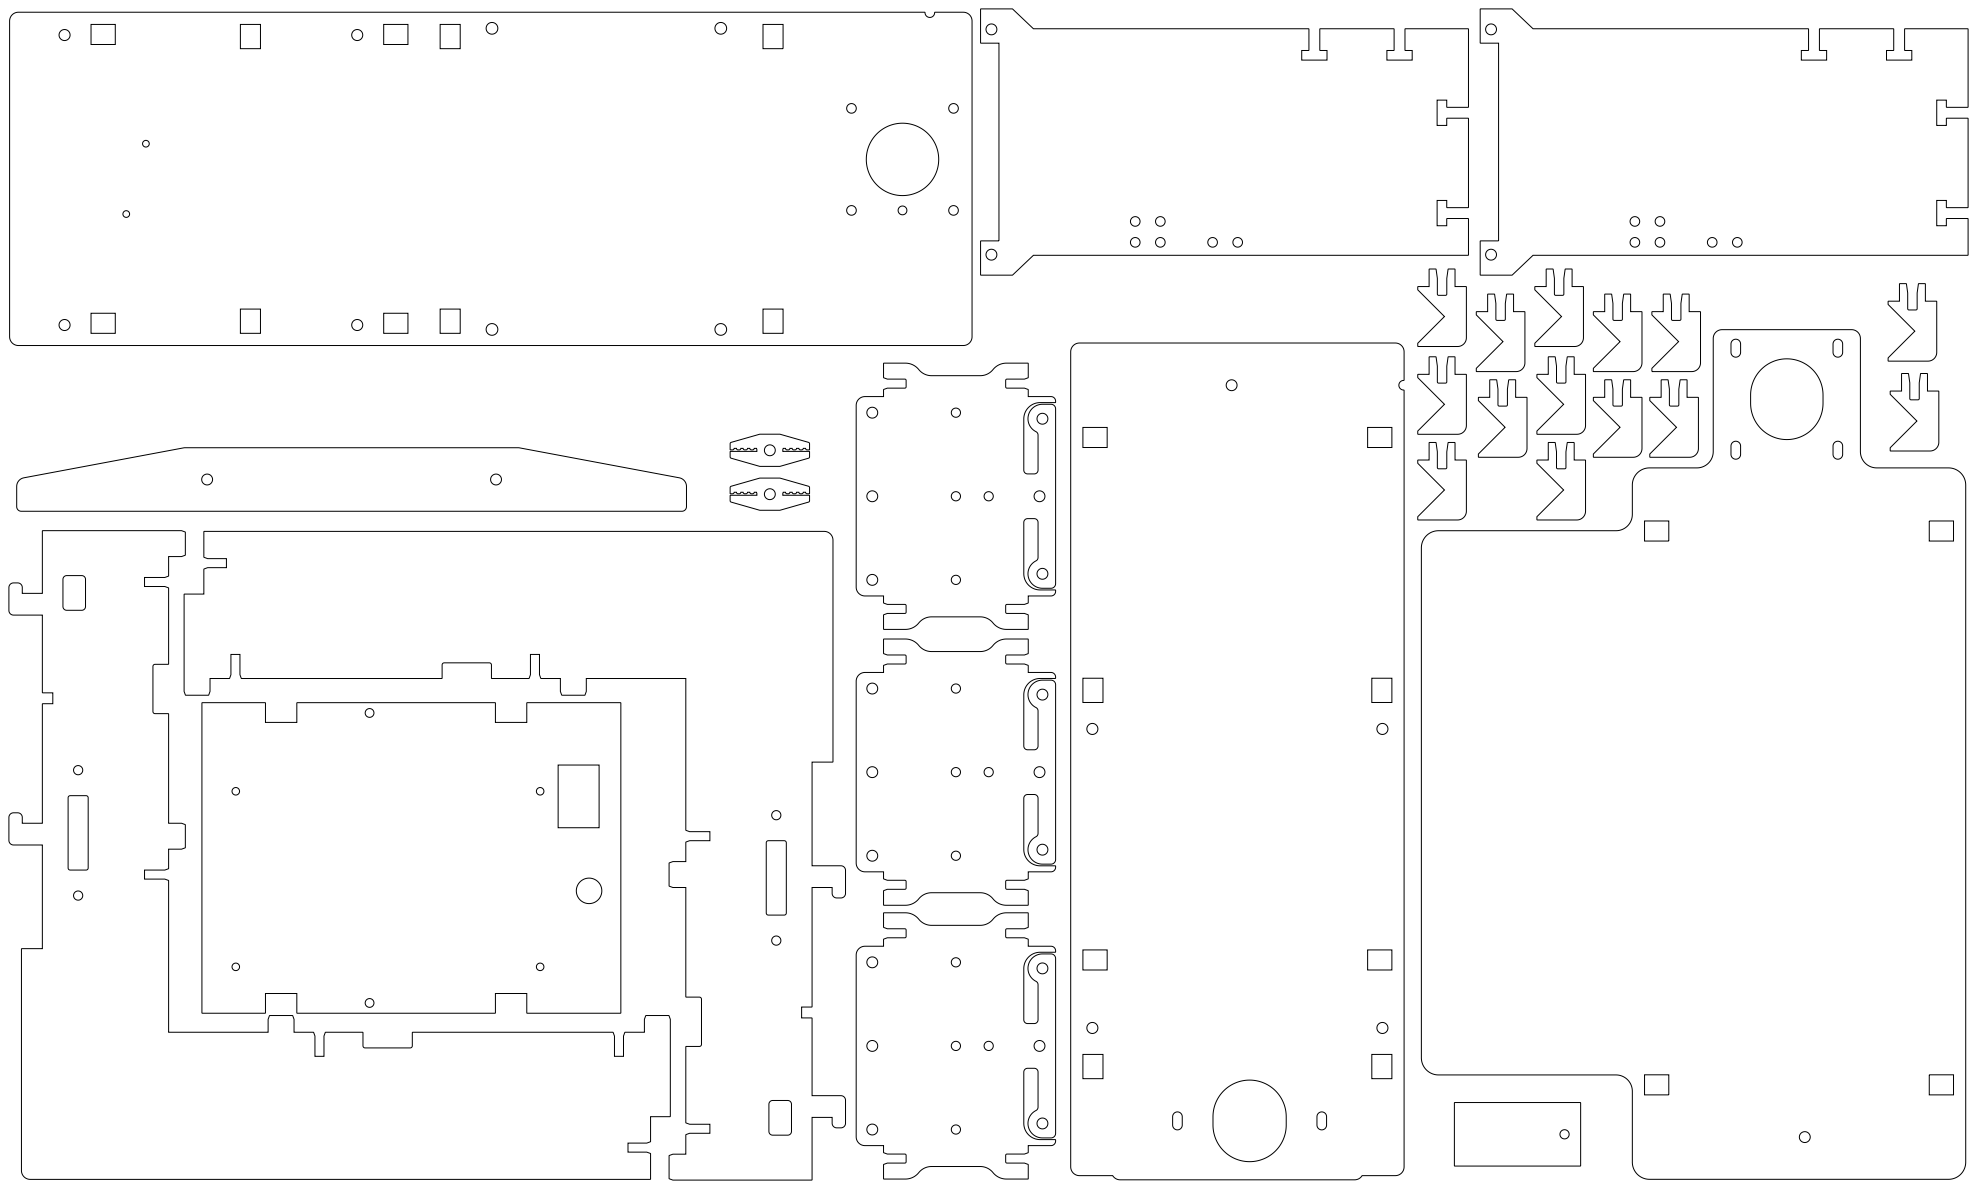
[picture p42: page 1]
