FoundryPrinter/Kerrby/(commit log)

2015-07-17 Update Extruder_Top_Tube_Holder
    [Extruder_Top_Tube_Holder.STL]
2015-07-17 Update Print Spec Files
2015-07-17 Clean out 2d Cut Files
    [L_bracket.DXF, back2.DXF, base2.DXF, carriageplate3.DXF, cover.DXF, extruderplate.DXF, foot.DXF, heaterblock.DXF]
2015-07-17 Massive Sorting and renaming of Solidworks Files
    [Back_Plate.SLDDRW, Back_Plate.SLDPRT, Blowerduct.SLDPRT, Bottom_Plate.SLDDRW, Bottom_Plate.SLDPRT, Extruder_Top_Tube_Holder.SLDPRT, Filament_Rocker.SLDPRT, Filiment_Rocker.STL]
2015-07-17 Update Internal Organization
    Also Files now in 2015 Solidworks
    [Back_Plate.SLDPRT, Blowerduct.SLDPRT, Bottom_Plate.SLDPRT, Extruder_Top_Tube_Holder.SLDPRT, Filament_Rocker.SLDPRT, MXL18_print.SLDPRT, Rail_Bracket.SLDPRT, Support_Bracket.SLDPRT]
2015-07-24 BOM Updates
    [3dprinter_BOM2.ods]
2015-07-31 Update BOM and some Solidworks files
    [3dprinter_BOM2.ods, Blowerduct.SLDPRT, Extruder_Top_Tube_Holder.SLDPRT, hotend.SLDASM, printer.SLDASM]
2015-07-31 Update BOM and Tube Holder stl
    [3dprinter_BOM2.ods, Extruder_Top_Tube_Holder.STL]
2015-07-31 Update BOM
    [3dprinter_BOM2.ods]
